philippejadin/zoetrope/hardware/enclosure/zoetrope laser cut.pdf

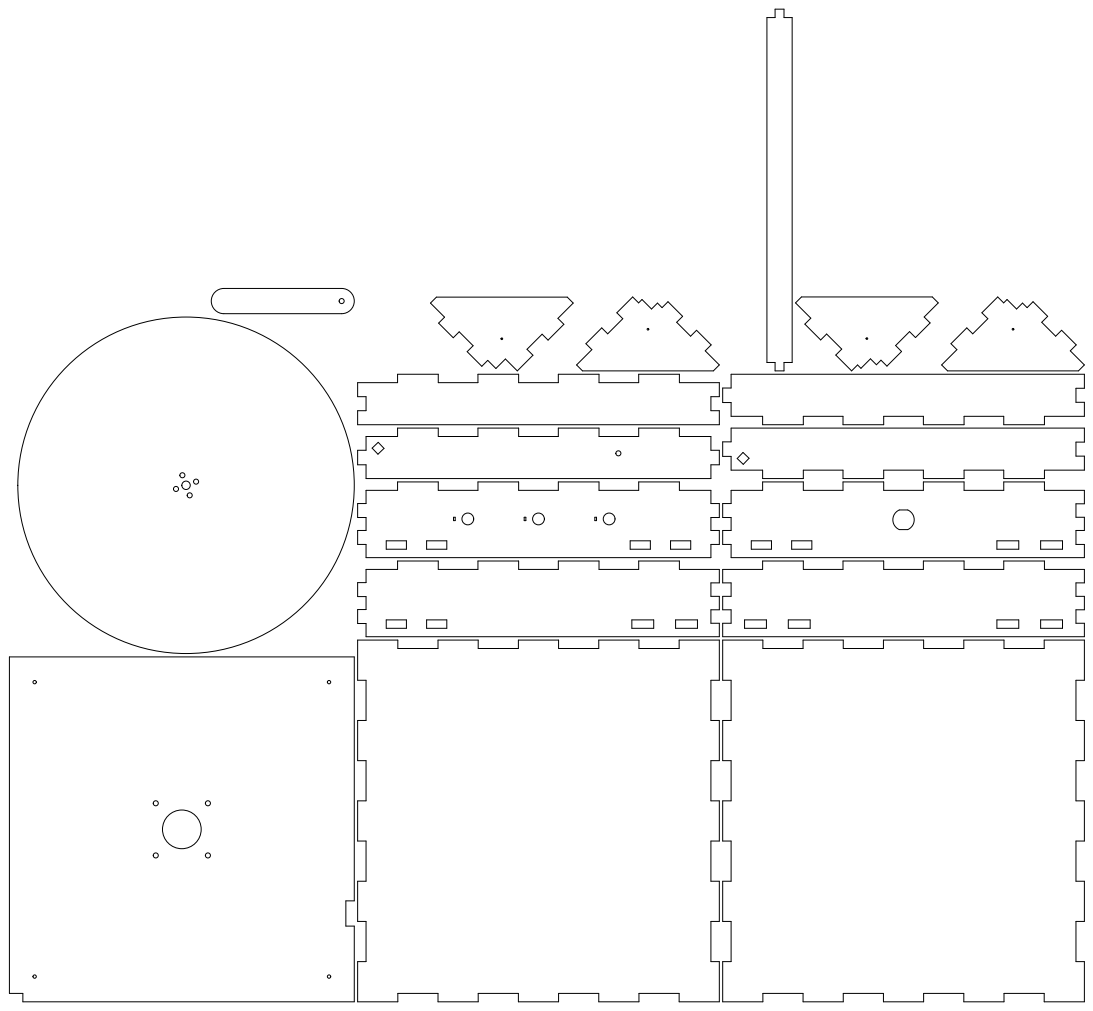
[picture p1: page 1]
