philippejadin/zoetrope/(list of files, drawings)

Other design files:
hardware/pcb/pcb_kicad.dsn
