philippejadin/zoetrope/hardware/pcb/pcb_kicad.kicad_pcb

## KiCad design hardware/pcb/pcb_kicad.kicad_pcb (2021-10-30)

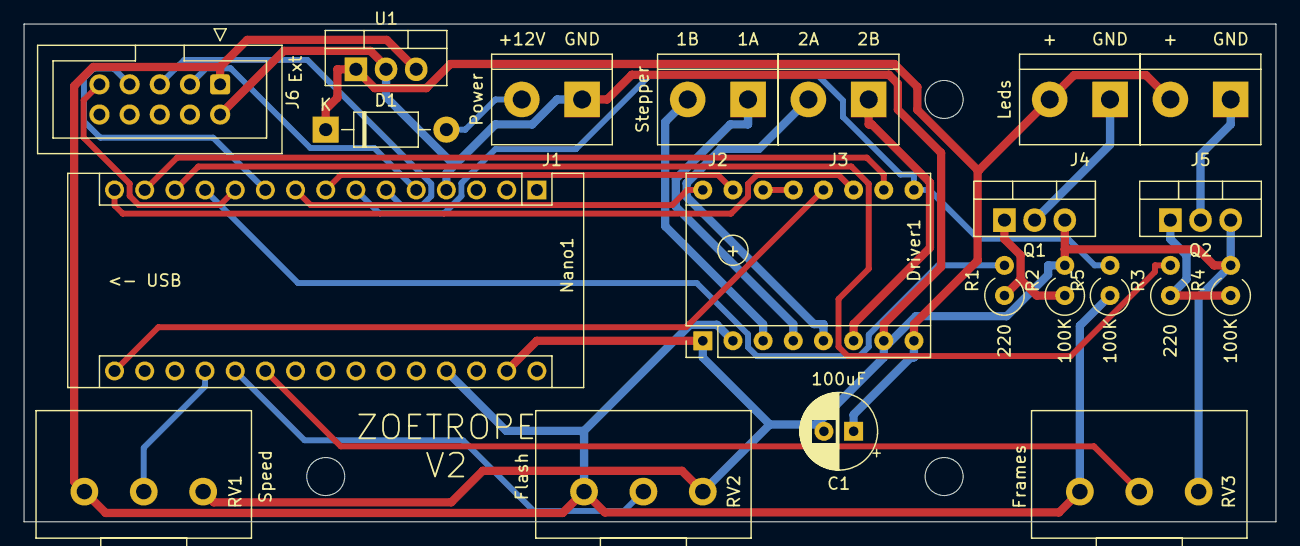
[picture p2: board pcb_kicad.kicad_pcb from above]

Board: 2 copper layers, 105.4 x 41.9 mm, 24 parts (0 on the bottom side), 28 nets.

Parts:
C1: 100uF; CP_Radial_D6.3mm_P2.50mm
D1: 1N4004; D_DO-41_SOD81_P10.16mm_Horizontal
Driver1: Pololu_Breakout_A4988; Pololu_Breakout-16_15.2x20.3mm
H2, H3, H4: MountingHole; MountingHole_3.2mm_M3
J1, J2, J3, J4, J5: Screw_Terminal_01x02; TerminalBlock_bornier-2_P5.08mm
J6: Conn_02x05_Odd_Even; IDC-Header_2x05_P2.54mm_Vertical
Nano1: Arduino_Nano_v3.x; Arduino_Nano
Q1, Q2: IRLB8721PBF; TO-220-3_Vertical
R1, R3: 220; R_Axial_DIN0309_L9.0mm_D3.2mm_P2.54mm_Vertical
R2, R4, R5: 100K; R_Axial_DIN0309_L9.0mm_D3.2mm_P2.54mm_Vertical
RV1, RV2, RV3: R_POT; Potentiometer_Alps_RK163_Single_Horizontal
U1: LM7805_TO220; TO-220-3_Vertical

Connections:
+5V: Driver1.2, J6.1, Nano1.27, R5.1, RV1.1, RV2.1, RV3.1, U1.3
+12V: C1.1, D1.1, Driver1.8, J4.2, J5.2, U1.1
/D2: J6.3, Nano1.5
/D3: J6.5, Nano1.6
/D7: J6.7, Nano1.10
/D8: J6.9, Nano1.11
/DIR: Driver1.16, Nano1.9
/ENABLE: Driver1.9, Nano1.7, R5.2
/LED1: Nano1.12, R1.2
/LED2: Nano1.13, R3.2
/MS1: Driver1.10, Nano1.14
/MS2: Driver1.11, Nano1.15
/MS3: Driver1.12, Nano1.16
/STEP: Driver1.15, Nano1.8
GND: C1.2, Driver1.1, Driver1.7, J1.1, J6.2, Nano1.4, Nano1.29, Q1.3, Q2.3, R2.2, R4.2, RV1.3, RV2.3, RV3.3, U1.2
unnamed: D1.2, J1.2
unnamed: Driver1.3, J2.2
unnamed: Driver1.4, J2.1
unnamed: Driver1.5, J3.2
unnamed: Driver1.6, J3.1
unnamed: Driver1.13, Driver1.14
unnamed: J4.1, Q1.2
unnamed: J5.1, Q2.2
unnamed: Nano1.19, RV1.2
unnamed: Nano1.20, RV2.2
unnamed: Nano1.21, RV3.2
unnamed: Q1.1, R1.1, R2.1
unnamed: Q2.1, R3.1, R4.1
