philippejadin/zoetrope/zoetrope_moteur_pas_a_pas_avec_flash_all_in_one_01/zoetrope_moteur_pas_a_pas_avec_flash_all_in_one_01.ino

/*
  Version du 1er octobre 2021

  Le flash s'allume et s'éteint dans la même boucle, plus précis pour le flash, moins précis pour les steps
  Essai de mettre un avant arrière pour le potentiomètre vitesse
  Désactive le moteur quand il ne tourne pas (évite de chauffer)

*/



/* Réglages du zoetrope en lui meme */
unsigned long motor_interval = 2400; // en microsecondes +- minimum 1300

unsigned long motor_interval_min = 800;
unsigned long motor_interval_max = 8000;


unsigned long inactive_area = 400;


unsigned long flash_duration = 1000; // motion blur : 1000 : nickel, 1500 plus lumineux, jusque 5500 (ultra blanc)
unsigned long flash_duration_min = 0;
unsigned long flash_duration_max = 3000;


int steps = 400; // Nombre de pas du stepper
int frames = 16; // nombre d'images dans l'animation
unsigned long micro;

int motorspeed = 512;
int previous_motorspeed = 512;


/* HARDWARE pins */

int motorclock = 3;      // select the pin for the stepper motor clock
int motordata = 6;      // select the pin for the stepper motor data

int motordisable = 10;      // select the pin to disable the motor data

int ledPin = 8; // pin pour le flash

int motor_interval_pot_pin = 0; // potentiometer pint to set motor interval
int flash_duration_pot_pin = 1; // potentiometer pint to set flash duration


unsigned long last_flash_on = 0;


/* setup */
int val = 0;
int compteur = 0;



void setup() {
  // declare the ledPin as an OUTPUT:
  pinMode(motorclock, OUTPUT);
  pinMode(motordata, OUTPUT);
  pinMode(ledPin, OUTPUT);
  pinMode(motordisable, OUTPUT);

  Serial.begin(9600);

}

void loop()
{

  micro = micros();



    // set motor speed from potentiometer
    val = analogRead(motor_interval_pot_pin);
    motorspeed = map(val, 0, 1024, 0, 1024);

    if (previous_motorspeed > motorspeed)
    {
      motorspeed ++;
      previous_motorspeed = motorspeed;
    }

    if (previous_motorspeed < motorspeed)
    {
      motorspeed --;
      previous_motorspeed = motorspeed;
    }


    if (motorspeed < 512)
    {
      motor_interval = map(motorspeed, 512, 0, motor_interval_max, motor_interval_min);
      digitalWrite(motordata, HIGH);
    }
    else
    {
      motor_interval = map(motorspeed, 512, 1024, motor_interval_max, motor_interval_min);

      digitalWrite(motordata, LOW);
    }

  




  // set flash speed from potentiometer
  val = analogRead(flash_duration_pot_pin);
  //val = 500;
  flash_duration = map(val, 1024, 0, flash_duration_min, flash_duration_max);

  flash_duration = 1000;


  // en rotation :
  if (motor_interval < motor_interval_max - inactive_area)
  {
    // on allume le flash
    if (compteur == (steps / frames))
    {

      digitalWrite(ledPin, HIGH);
      last_flash_on = micro;
      delayMicroseconds(flash_duration);
      digitalWrite(ledPin, LOW);
      compteur = 0;
    }
/*
    // cette boucle stabilise parfaitement  l'anim mais en échange plus le flash est fort plus l'anim est lente :
    
      else {
      delayMicroseconds(flash_duration);
      }
    
*/

    // enable stepper output
    digitalWrite(motordisable, LOW);
    digitalWrite(motorclock, HIGH);
    delayMicroseconds(200);
    digitalWrite(motorclock, LOW);
    delayMicroseconds(motor_interval / 2);

    compteur++;




  }
  else // on allume gentiment la led pour y voir quelque chose
  {

    val = analogRead(flash_duration_pot_pin);
    flash_duration = map(val, 1024, 0, flash_duration_min, flash_duration_max / 5);
    flash_duration = constrain(flash_duration, flash_duration_min, flash_duration_max / 5);



    digitalWrite(ledPin, HIGH);
    delayMicroseconds(flash_duration);
    digitalWrite(ledPin, LOW);
    delayMicroseconds(1500);


    // disable stepper output
    digitalWrite(motordisable, HIGH);

  }

}
