philippejadin/zoetrope/(commit log)

2021-10-02 using kicad
    [pcb_kicad-B_Cu.gbr, pcb_kicad-B_Mask.gbr, pcb_kicad-Edge_Cuts.gbr, pcb_kicad-F_Cu.gbr, pcb_kicad-F_Mask.gbr, pcb_kicad-F_SilkS.gbr, pcb_kicad-NPTH.drl, pcb_kicad-PTH.drl]
2021-10-03 better latyout?
    [pcb_kicad.dsn, pcb_kicad.kicad_pcb, pcb_kicad.sch]
2021-10-08 best run so far
    [pcb_kicad 2.kicad_pcb, pcb_kicad.dsn, pcb_kicad.kicad_pcb, pcb_kicad.sch, pcb_kicad_nickel.kicad_pcb, pcb_kicad_ok.kicad_pcb, pcb_kicad_routed.kicad_pcb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]
2021-10-15 methode millis fonctionne !
2021-10-18 v1 pour pcb v1
2021-10-22 allow set frames per disk using third pot
2021-10-22 max acceleration control of stepper
2021-10-22 new pcb
    [pcb_kicad.kicad_pcb]
2021-10-22 v2 to be checked
    [pcb_kicad.dsn, pcb_kicad.kicad_pcb, pcb_kicad.sch]
2021-10-24 final revision of PCB V1
    [pcb_kicad.dsn, pcb_kicad.kicad_pcb, pcb_kicad.sch]
2021-10-24 v 1.1 to be checked
    [pcb_kicad.kicad_pcb]
2021-10-28 built in led flash
2021-10-28 pcb V2 wip
    [pcb_kicad.dsn, pcb_kicad.kicad_pcb, pcb_kicad.sch]
2021-10-28 latest V
    [pcb_kicad.dsn, pcb_kicad.kicad_pcb]
2021-10-30 added enclosure, removed old fritzing files
    [zoetrope01.fzz]
2021-10-30 moved pcb files
    [pcb_kicad 2.kicad_pcb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]
